analogicus/cnr_gr05_sky130nm/README.md

# CNR_GR05_SKY130NM

# Who
wulff

# Why
 <explain why you made this module>

# How
 <explain short how you made this module>

# What

| What | Lib/Folder | Cell/Name |
| :- | :-: | :-: |
| Schematic | CNR_GR05_SKY130NM | CNR_GR05 |
| Layout | CNR_GR05_SKY130NM | CNR_GR05 |
| LPE | CNR_GR05_SKY130NM | CNR_GR05 |

# Changelog/Plan
| Version | Status | Comment|
| :-| :-| :-|
|0.1.0 | :x: | Make something |

# Signal interface
| Signal | Direction | Domain  | Description |
| :--- | :---: | :---: | :--- |
| VDD_1V8 | Input | VDD_1V8 | Main supply |
| VSS | Input | Ground  | |
| PWRUP_1V8 | Input | VDD_1V8 | Power up the circuit |

# Key parameters
| Parameter | Min | Typ | Max | Unit  |
| :--- | :-: | :-: | :-: | :---: |
| Technology | | Skywater 130 nm | | |
| AVDD | 1.7 | 1.8 | 1.9 | V |
| Temperature | -40 | 27 | 125 | C |

# Status

| Stage | TYPE | Status | Comment |
| :--- | :-:  | :---:  | :--: |
| Specification | DOC  | :x: | |
| Schematic | VIEW | :x: | |
| Schematic simulation | VER  | N/A | |
| Layout | VIEW | :x: | |
| Layout parasitic extraction | VIEW | :x: | |
| LPE simulation | VER  | :x: | |
| LVS | VER  | :x: | |
| DRC | VER  | :x: | |
| ERC | VER  | :x: | |
| ANT | VER  | :x: | |
