analogicus/cnr_gr05_sky130nm/documents/Assignment-M1-Advanced-Integrated-Circuits-Group-5.pdf

Department of Electronic Systems

TFE 4188 - Advanced Integrated Circuits

# Assignment M1 - Group 5

Authors:
Markus Pedersen
Andrea Al Muktash
Michal Rowicki
Trond Christiansen

Date: 08.02.2024

## Table of Contents

List of Figures | ii
1 Introduction | 1
2 Key Parameters | 1
3 Specification | 1
4 Verification Plan | 1
5 Functional Description | 2
6 Architecture | 2
7 SPICE Simulations | 4

i

## List of Figures

1 | OTA design | | 2
2 | Top level design | | 3
3 | Simulation of current and temperature from -40 °C to 125 °C in cicsim | | 4
4 | Simulation of current and temperature from -40 °C to 125 °C in NGSPICE . . . . | 4
5 | Plots of measured current and ideal current from -40 °C to 125 °C | | 5
6 | Simulated current consumption from -40 °C to 125 °C | | 5

ii

## 1 Introduction

For this milestone, the goal is to create a circuit design that implements the functionality of con-verting a temperature to a current. The design utilizes the Skywater Open Source PDK and its SKY130 process node.

This report serves as preliminary documentation of the current progress of the project.

## 2 Key Parameters

The following table presents the key parameters for the design.

Table 1: Key parameters

Name | Description | Min | Typ | Max | Unit
Width | Maximum width | - | - | 160 | µm
Height | Maximum height | - | - | 100 | µm
VDD | Input supply | 1.62 | 1.80 | 1.98 | V
Temperature | Temperature range to measure | -40 | - | 125 | °C
Current | Input current | - | 120 | 200 | µA

## 3 Specification

The following table presents the specifications for the design.

Table 2: Specifications

Name | Description | Min | Typ | Max | Unit | Notes
Accuracy | One-point accuracy | -5 | 0 | +5 | °C | -
Resolution | Temperature resolution | - | - | - | °C | TBD
Stability | - | - | - | - | - | TBD
Power consumption Noise | -Noise of the OTA | -- | -- | -- | W V /√ | TBD
| | | | | Hz | TBD
Offset | Offset of the OTA | - | - | - | V | TBD
CMRR | CMRR of the OTA | - | - | - | dB | TBD
Gain | Gain of the OTA | - | - | - | - | TBD

## 4 Verification Plan

### 4.1 Accuracy

The accuracy of the current-to-temperature design will be verified by simulating the design in the entire temperature range. Afterward, the data will be extracted and compared to the ideal current function.

### 4.2 Current Consumption

The current consumption of the design will be simulated by measuring the current from the supply for the entire temperature range using a DC analysis testbench.

## 5 Functional Description

The project group is designing an IC temperature sensor using the SkyWater130 CMOS technology.

The intention is to use a circuit that generates a PTAT current. It is based on a modified Kuijk band gap reference mechanism i.e. using the VBE voltage of a BJT (used as a diode):

VBE =

kT
q
- ln(

ID
IS

)

## 6 Architecture

### 6.1 OTA Subcircuit

The following figure presents the OTA subcircuit:

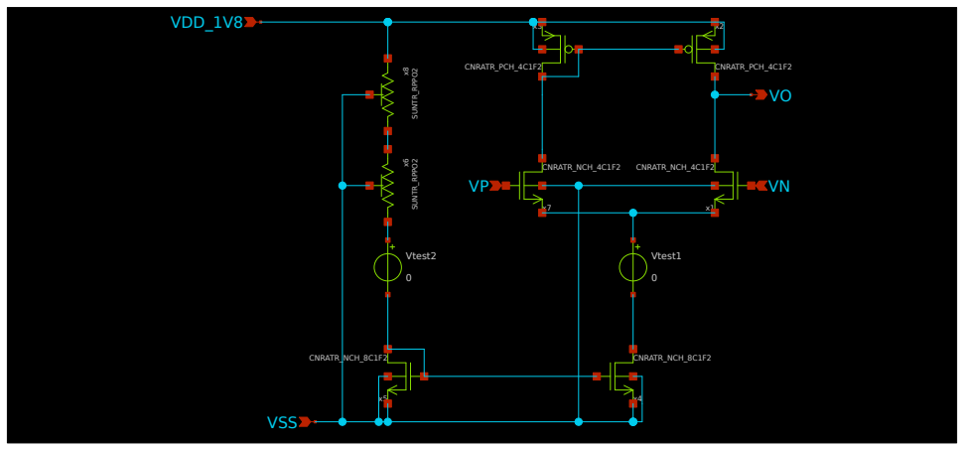
[picture p2: figure]
VDD_1V8; VSS; Vtest1; CNRATR_NCH_4C1F2; CNRATR_PCH_4C1F2; CNRATR_NCH_8C1F2; Vtest2; SUNTR_RPPO2

Figure 1: OTA design

The amplifier in negative feedback forces a 0 differential voltage. Hence, scaling the diode sizes properly, one can get a resulting voltage drop over the resistance of VB1 − VB2, thus generating the PTAT current:

IP T AT =

kT
q
- ln(n) ·

1
R

To bias the simple five-transistor OTA, a 60 µA current is desired. For that current, the 8C1F2 has a given gate-source voltage of VGS = 0.75V for gm
id

= 15. Since the supply voltage is VDD = 1.8, the required resistor value can be calculated using:

R =

VDD − VGS
I

=

1.8V − 0.75V
60µA = 17.5kΩ

The implemented design uses two 8.8 k Ω in series.
The tail transistor is twice the size of the input transistors so it can carry twice the current.

### 6.2 Top Design

The following figure presents the top-level design: VP

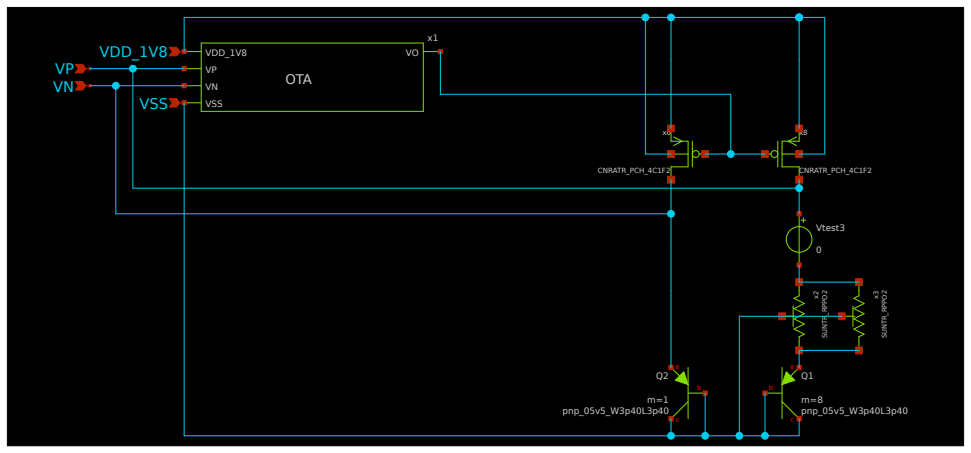
[picture p3: figure]
VSS; VDD_1V8; pnp_05v5_W3p40L3p40; CNRATR_PCH_4C1F2; Vtest3; SUNTR_RPPO2; OTA

Figure 2: Top level design

The pnp BJTs work similar to diodes when operating in the triode region. The diode current
I = IS · e

qVBE
kT

where the reverse saturation current is proportional to the emitter area

IS ∝ AE

implies that

VBE =

kT
q

ln(

I
IS

)

From this, one can calculate the voltage drop over the resistors:

VR = VEB1 − VEB2 =

kT
q
- ln(

I1
IS1

) −

kT
q
- ln(

I2
IS2

) = kT
q
- ln(n)

where n is the ratio of the pnp emitter areas.
Using an equivalent resistance of 4.4kΩ and a pnp emitter area ratio of n = 8, one can calculate the predicted ideal slope of the temperature to current function:

Iout =

kT
q
- ln(n)

4.4kΩ

∝ T

Iout
T

=

k
q
- ln(8) ·

1
4.4kΩ

≈ 40.8nA/K

## 7 SPICE Simulations

All simulations presented in this section were performed in the typical corner.

### 7.1 Simulation of Current against Temperature

The following figures present the simulation results of the proposed design. The simulations were performed by configuring a temperature sweep from -40 °C to 125 °C using the following SPICE commands:

op t r an 1 1 1 10n 20u 0
DC temp −40 125 1

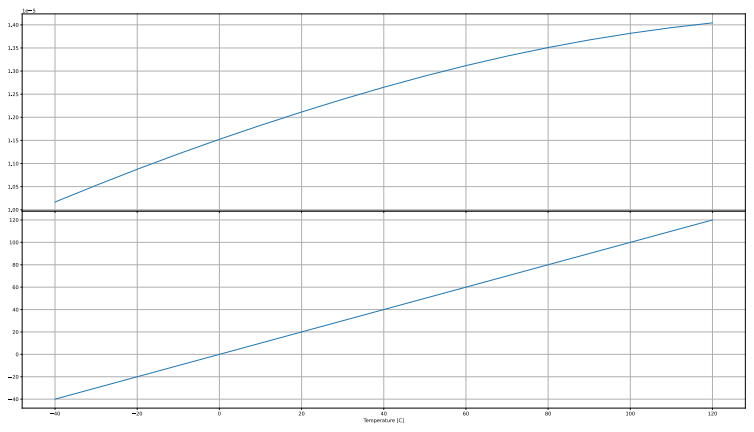
[picture p4: figure]

Figure 3: Simulation of current and temperature from -40 °C to 125 °C in cicsim

temp-sweep

dc1: cicsimgen tran

-40.0 | -20.0 | 0.0 | 20.0 | 40.0 | 60.0 | 80.0 | 100.0 | 120.0
| | | | | Celsius

10.0

10.5

11.0

11.5

12.0

12.5

13.0

13.5

14.0

14.5

uA | i(v.xdut.vtest3)

Figure 4: Simulation of current and temperature from -40 °C to 125 °C in NGSPICE

### 7.2 Calculation of Current Error

By extracting the data and running it in a simple Python script, one can compute the error of the measured current compared to the ideal current, as shown in the following figure:

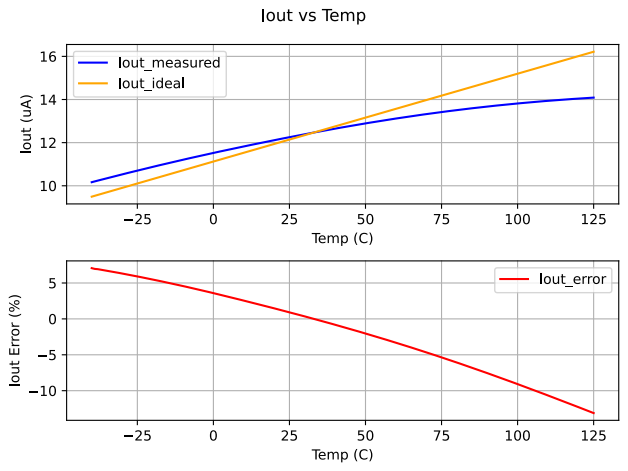
[picture p5: figure]

Figure 5: Plots of measured current and ideal current from -40 °C to 125 °C

One can observe that the measured current curve is non-linear and deviates from the ideal current by up to 14 %. The group hypothesizes that this is caused by the temperature dependence of the resistors and intends to address this in the next revision.

### 7.3 Simulation of Current Consumption

The following figure shows the simulated current consumption of the circuit:

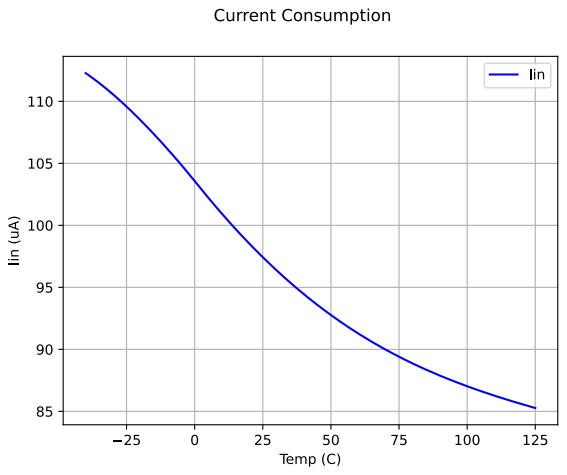
[picture p6: figure]

Figure 6: Simulated current consumption from -40 °C to 125 °C

The current consumption decreases due to the mirror ratio in the OTA worsening, which is some-thing requiring further investigation. A possible hypothesis is the tail current going into the ohmic region.
