analogicus/cnr_gr05_sky130nm/design/CNR_GR05_SKY130NM/Openlane/PulseDurationMeasurement/runs/RUN_2024.04.19_11.37.55/reports/metrics.csv

design | design_name | config | flow_status | total_runtime | routed_runtime | (Cell/mm^2)/Core_Util | DIEAREA_mm^2 | CellPer_mm^2 | OpenDP_Util | Final_Util | Peak_Memory_Usage_MB | synth_cell_count | tritonRoute_violations | Short_violations | MetSpc_violations | OffGrid_violations | MinHole_violations | Other_violations | Magic_violations | pin_antenna_violations | net_antenna_violations | lvs_total_errors | cvc_total_errors | klayout_violations | wire_length | vias | wns | pl_wns | optimized_wns | fastroute_wns | spef_wns | tns | pl_tns | optimized_tns | fastroute_tns | spef_tns | HPWL | routing_layer1_pct | routing_layer2_pct | routing_layer3_pct | routing_layer4_pct | routing_layer5_pct | routing_layer6_pct | wires_count | wire_bits | public_wires_count | public_wire_bits | memories_count | memory_bits | processes_count | cells_pre_abc | AND | DFF | NAND | NOR | OR | XOR | XNOR | MUX
/openlane/designs/PulseDurationMeasurement | PulseDurationMeasurement | RUN_2024.04.19_11.37.55 | flow failed | 1h6m10s0ms | 0h51m5s0ms | 102368.54600276935 | 0.3779871993 | 51184.273001384674 | 51.19 | 45.384299999999996 | 1244.77 | 18964 | 0 | 0 | 0 | 0 | 0 | 0 | 0 | 27 | 19 | 0 | -1 | -1 | 628886 | 137793 | -3.41 | -1 | -1 | -1 | -1 | -38.65 | -1 | -1 | -1 | -1 | 510097031.0 | 0.0 | 46.68 | 50.16 | 11.22 | 22.14 | 0.0 | 19963 | 20516 | 51 | 465 | 0 | 0 | 0 | 20485 | 75 | 155 | 500 | 1064 | 2829 | 3527 | 2042 | 1375
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
