analogicus/cnr_gr05_sky130nm/design/CNR_GR05_SKY130NM/Openlane/PulseDurationMeasurement/runs/RUN_2024.04.19_13.24.54/reports/metrics.csv

design | design_name | config | flow_status | total_runtime | routed_runtime | (Cell/mm^2)/Core_Util | DIEAREA_mm^2 | CellPer_mm^2 | OpenDP_Util | Final_Util | Peak_Memory_Usage_MB | synth_cell_count | tritonRoute_violations | Short_violations | MetSpc_violations | OffGrid_violations | MinHole_violations | Other_violations | Magic_violations | pin_antenna_violations | net_antenna_violations | lvs_total_errors | cvc_total_errors | klayout_violations | wire_length | vias | wns | pl_wns | optimized_wns | fastroute_wns | spef_wns | tns | pl_tns | optimized_tns | fastroute_tns | spef_tns | HPWL | routing_layer1_pct | routing_layer2_pct | routing_layer3_pct | routing_layer4_pct | routing_layer5_pct | routing_layer6_pct | wires_count | wire_bits | public_wires_count | public_wire_bits | memories_count | memory_bits | processes_count | cells_pre_abc | AND | DFF | NAND | NOR | OR | XOR | XNOR | MUX
/openlane/designs/PulseDurationMeasurement | PulseDurationMeasurement | RUN_2024.04.19_13.24.54 | flow completed | 0h4m17s0ms | 0h3m6s0ms | 92474.72410474686 | 0.033414536025000004 | 46237.36205237343 | 52.05 | 64.55199999999999 | 567.47 | 1199 | 0 | 0 | 0 | 0 | 0 | 0 | 0 | 0 | 0 | 0 | -1 | -1 | 36073 | 9421 | 0.0 | -1 | -1 | -1 | -1 | 0.0 | -1 | -1 | -1 | -1 | 22116453.0 | 0.0 | 36.54 | 36.76 | 3.07 | 5.0 | 0.0 | 495 | 796 | 45 | 325 | 0 | 0 | 0 | 782 | 23 | 32 | 18 | 4 | 52 | 5 | 6 | 282
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
