analogicus/cnr_gr05_sky130nm/design/CNR_GR05_SKY130NM/Openlane/PulseDurationMeasurement/src/verilog_include_file.v

// Macros
`define STA         0       // Status register          0x00    RO
`define TMPH        1       // Temperature high byte    0x01    RO  
`define TMPL        2       // Temperature low byte     0x02    RO
`define RAWH        3       // Raw data high byte       0x03    RO
`define RAWL        4       // Raw data low byte        0x04    RO
`define CTL         5       // Control register         0x05    RW
`define RES1        6       // Reserved                 0x06    RW
`define RES2        7       // Reserved                 0x07    RW
`define OFS_3       8       // Offset register 3        0x08    RW
`define OFS_2       9       // Offset register 2        0x09    RW
`define OFS_1       10      // Offset register 1        0x0A    RW
`define OFS_0       11      // Offset register 0        0x0B    RW
`define OFS_SHA     12      // Offset Shift amount reg  0x0C    RW
`define GAIN1_3     13      // Gain1 register 3         0x0D    RW
`define GAIN1_2     14      // Gain1 register 2         0x0E    RW
`define GAIN1_1     15      // Gain1 register 1         0x0F    RW
`define GAIN1_0     16      // Gain1 register 0         0x10    RW
`define GAIN1_SHA   17      // Gain1 shift amount reg   0x11    RW
`define GAIN2_3     18      // Gain2 register 3         0x12    RW
`define GAIN2_2     19      // Gain2 register 2         0x13    RW
`define GAIN2_1     20      // Gain2 register 1         0x14    RW
`define GAIN2_0     21      // Gain2 register 0         0x15    RW
`define GAIN2_SHA   22      // Gain2 shift amount reg   0x16    RW
`define GAIN3_3     23      // Gain3 register 3         0x17    RW
`define GAIN3_2     24      // Gain3 register 2         0x18    RW
`define GAIN3_1     25      // Gain3 register 1         0x19    RW
`define GAIN3_0     26      // Gain3 register 0         0x1A    RW
`define GAIN3_SHA   27      // Gain3 shift amount reg   0x1B    RW



module PulseDurationMeasurement(
    input wire clk,             // Clock input
    input wire reset_n,         // Reset input
    input wire RS,              // Register Select input
    input wire RW,              // Read/Write input
    input wire EN,              // Enable input
    input wire [7:0] data_in,   // Data bus input
    input wire signal_in,       // Signal input
    output reg [7:0] data_out   // Data bus output
);

// Internal variables
reg [5:0] address = 1'b000000;            // Address bus 6-bit
reg [7:0] data_reg [30:0];           // Data register 8-bit

reg state = 0;
reg [11:0] count, pulse_duration;

reg signed [31:0] c_offset, c_gain1, c_gain2, c_gain3;
reg signed [15:0] temperature_output = 0; // Signed temperature value output
reg [64:0] tmp;

reg [32:0] u_offset, u_gain1, u_gain2, u_gain3;
reg [7:0] u_offset_sha, u_gain1_sha, u_gain2_sha, u_gain3_sha;

// Constants declaration
parameter IDLE = 1'b0;
parameter COUNT = 1'b1;

// Constants for temperature conversion
parameter GAIN3 = -508; // (-0.0000004731 * 1073741824) scaled by 2^30
parameter GAIN2 = 2101; // (0.0020044419 * 1048576) scaled by 2^20
parameter GAIN = -2532; // (-2.4734734627 * 1024) scaled by 2^10
parameter OFFSET = 847;

parameter CALEN_bm = (1 << 7);  // Calibration enable bit mask
parameter CALSEL_bm = ((1 << 6) | (1 << 5));  // Calibration 3 bit mask
parameter CAL_3 = ((1 << 6) | (1 << 5));  // Calibration 3
parameter CAL_2 = ((1 << 6) | (0 << 5));  // Calibration 2
parameter CAL_1 = ((0 << 6) | (1 << 5));  // Calibration 1
parameter CAL_0 = ((0 << 6) | (0 << 5));  // Calibration 0


always_ff @(posedge clk) begin
    if(!reset_n) begin
        data_out = 8'b00000000;
        address = 6'b000000;
    end
    else if(EN == 1) begin
        if(RS == 1 && RW == 0) begin        // Read data
            data_out = data_reg[address];
            if(data_reg[address] != 0) begin
                //$display($stime,"\t\t\t\t\t Reading data %d from address %d", data_out, address);
            end
        end
        else if(RS == 1 && RW == 1) begin   // Write data
        // TODO: Write protection for read-only registers
            if(address >= 5 && address <= 30) begin
                data_reg[address] = data_in;
                //$display($stime,"\t\t\t\t\tWriting data %d to address %d", data_in, address);
            end
        end
        else if(RS == 0 && RW == 0) begin   // Read address
            data_out = address;
            if(address != 0) begin
                //$display($stime,"\t\t\t\t\tReading address %d", address);
            end
        end
        else if(RS == 0 && RW == 1) begin   // Write address
            address = data_in[5:0];
            //$display($stime,"\t\t\t\t\tAddress set to %d from %d", address, data_in);
        end
        else begin                          // Default
            data_out = 8'b00000000;
        end
    end
end

always_ff @(posedge clk) begin
    if(!reset_n) begin
        state <= IDLE;
        count <= 12'h0;
    end else begin
        case(state)
            IDLE: begin
                count <= 12'b000000000001;
                if (signal_in == 0) begin
                    state <= COUNT;
                    // Calculated temperature message printed here at to allow for temperature conversion to be done
                    //$display($stime,"\t\t\t\t\tMeasurement finished \t\t Old temperature: %d \t New temperature:", temperature_output);
                end 
            end

            COUNT: begin
                if (signal_in == 0) begin
                    count <= count + 1;
                end else begin
                    pulse_duration <= count;

                    data_reg[`RAWH] <= 8'b0 | pulse_duration[11:8];
                    data_reg[`RAWL] <= pulse_duration[7:0];
                    // Finished counting message printed here at to only display once per measurement
                    //$display($stime,"\t\t\t\t\tCount finished \t\t Pulse Duration: %d", pulse_duration);
                    state <= IDLE;
                end
            end
        endcase
    end
end

//always_comb begin
always_ff @(posedge clk) begin
    // // Concatenate the offset registers to form a 32-bit signed integer
    // c_offset = data_reg[`OFS_3] << 24 | data_reg[`OFS_2] << 16 | data_reg[`OFS_1] << 8 | data_reg[`OFS_0];
    // c_gain1 = data_reg[`GAIN1_3] << 24 | data_reg[`GAIN1_2] << 16 | data_reg[`GAIN1_1] << 8 | data_reg[`GAIN1_0];
    // c_gain2 = data_reg[`GAIN2_3] << 24 | data_reg[`GAIN2_2] << 16 | data_reg[`GAIN2_1] << 8 | data_reg[`GAIN2_0];
    // c_gain3 = data_reg[`GAIN3_3] << 24 | data_reg[`GAIN3_2] << 16 | data_reg[`GAIN3_1] << 8 | data_reg[`GAIN3_0];


    c_offset =  data_reg[`OFS_1] << 8 | data_reg[`OFS_0];
    c_gain1 =  data_reg[`GAIN1_1] << 8 | data_reg[`GAIN1_0];
    c_gain2 =  data_reg[`GAIN2_1] << 8 | data_reg[`GAIN2_0];
    c_gain3 =  data_reg[`GAIN3_1] << 8 | data_reg[`GAIN3_0];


    if(!reset_n) begin
        temperature_output = 16'b0;
    end
    else if (data_reg[`CTL] & CALEN_bm) begin // Calibration enabled
        if ((data_reg[`CTL] & CALSEL_bm) == CAL_0) begin

            // // Standard calibration with custom offset
            // tmp = ((GAIN3*pulse_duration*pulse_duration*pulse_duration) >> 30) 
            //         + ((GAIN2*pulse_duration*pulse_duration) >> 20) 
            //         + ((GAIN*pulse_duration) >> 10)
            //         + c_offset;
            // temperature_output = tmp[15:0];

            //u_gain1 = GAIN3;
            u_gain2 = GAIN2;
            u_gain3 = GAIN;
            u_offset = c_offset;

            u_gain1_sha = 30;
            u_gain2_sha = 20;
            //u_gain3_sha = 10;
            u_offset_sha = data_reg[`OFS_SHA];

            // $display($s  time,"\tstandard calibration with custom offset");
            // $display($stime,"\t %d * %d^3 / 2^%d + %d * %d^2 / 2^%d + %d * %d / 2^%d + %d", GAIN3, pulse_duration, 30, GAIN2, pulse_duration, 20, GAIN, pulse_duration, 10, c_offset);
            // $display($stime,"\t\t\tTemperature: %d", temperature_output);
        end
        else if ((data_reg[`CTL] & CALSEL_bm) == CAL_1) begin

            // tmp = ((c_gain1*pulse_duration) >> data_reg[`GAIN1_SHA]) 
            //         + (c_offset >> data_reg[`OFS_SHA]);
            // temperature_output = tmp[15:0];

            u_gain1 = c_gain1;
            u_gain2 = 0;
            //u_gain3 = 0;
            u_offset = c_offset;

            u_gain1_sha = data_reg[`GAIN1_SHA];
            u_gain2_sha = 0;
            //u_gain3_sha = 0;
            u_offset_sha = data_reg[`OFS_SHA];

            // $display($stime,"\tcustom calibration 1");
            // $display($stime,"\t %d * %d / 2^%d + %d", c_gain1, pulse_duration, data_reg[`GAIN1_SHA], c_offset);
            // $display($stime,"\t\t\tTemperature: %d", temperature_output);
        end
        else if ((data_reg[`CTL] & CALSEL_bm) == CAL_2) begin

            // tmp = ((c_gain2*pulse_duration*pulse_duration) >> data_reg[`GAIN2_SHA])
            //         + ((c_gain1*pulse_duration) >> data_reg[`GAIN1_SHA]) 
            //         + (c_offset >> data_reg[`OFS_SHA]);
            // temperature_output = tmp[15:0];

            u_gain1 = c_gain1;
            u_gain2 = c_gain2;
            //u_gain3 = 0;
            u_offset = c_offset;

            u_gain1_sha = data_reg[`GAIN1_SHA];
            u_gain2_sha = data_reg[`GAIN2_SHA];
            //u_gain3_sha = 0;
            u_offset_sha = data_reg[`OFS_SHA];

            // $display($stime,"\tcustom calibration 2");
            // $display($stime,"\t %d * %d^2 / 2^%d + %d * %d / 2^%d + %d", c_gain2, pulse_duration, data_reg[`GAIN2_SHA], c_gain1, pulse_duration, data_reg[`GAIN1_SHA], c_offset);
            // $display($stime,"\t\t\tTemperature: %d", temperature_output);
        end
        else if ((data_reg[`CTL] & CALSEL_bm) == CAL_3) begin

            // tmp = ((c_gain3*pulse_duration*pulse_duration*pulse_duration) >> data_reg[`GAIN3_SHA])
            //         + ((c_gain2*pulse_duration*pulse_duration) >> data_reg[`GAIN2_SHA])
            //         + ((c_gain1*pulse_duration) >> data_reg[`GAIN1_SHA]) 
            //         + (c_offset >> data_reg[`OFS_SHA]);
            // temperature_output = tmp[15:0];

            u_gain1 = c_gain1;
            u_gain2 = c_gain2;
            //u_gain3 = c_gain3;
            u_offset = c_offset;

            u_gain1_sha = data_reg[`GAIN1_SHA];
            u_gain2_sha = data_reg[`GAIN2_SHA];
            //u_gain3_sha = data_reg[`GAIN3_SHA];
            u_offset_sha = data_reg[`OFS_SHA];

            // $display($stime,"tustom calibration 3");
            // $display($stime,"\t %d * %d^3 / 2^%d + %d * %d^2 / 2^%d + %d * %d / 2^%d + %d", c_gain3, pulse_duration, data_reg[`GAIN3_SHA], c_gain2, pulse_duration, data_reg[`GAIN2_SHA], c_gain1, pulse_duration, data_reg[`GAIN1_SHA], c_offset);
            // $display($stime,"\t\t\tTemperature: %d", temperature_output);
        end

    end
    else begin  // Custom calibration disabled

        // tmp = ((GAIN3*pulse_duration*pulse_duration*pulse_duration) >> 30) 
        //             + ((GAIN2*pulse_duration*pulse_duration) >> 20) 
        //             + ((GAIN*pulse_duration) >> 10) 
        //             + OFFSET;
        // temperature_output = tmp[15:0];

        u_gain1 = GAIN3;
        u_gain2 = GAIN2;
        //u_gain3 = GAIN;
        u_offset = OFFSET;

        u_gain1_sha = 30;
        u_gain2_sha = 20;
        //u_gain3_sha = 10;
        u_offset_sha = 0;

        // $display($stime,"\tstandard calibration");
        // $display($stime,"\t %d * %d^3 / 2^%d + %d * %d^2 / 2^%d + %d * %d / 2^%d + %d", GAIN3, pulse_duration, 30, GAIN2, pulse_duration, 20, GAIN, pulse_duration, 10, OFFSET);
        // $display($stime,"\t\t\tTemperature: %d", temperature_output);
    end

    // tmp = ((u_gain3*pulse_duration*pulse_duration*pulse_duration) >> u_gain3_sha) 
    //         + ((u_gain2*pulse_duration*pulse_duration) >> u_gain2_sha) 
    //         + ((u_gain1*pulse_duration) >> u_gain1_sha) 
    //         + u_offset;
    // temperature_output = tmp[15:0];
    tmp = ((u_gain2*pulse_duration*pulse_duration) >> u_gain2_sha) 
            + ((u_gain1*pulse_duration) >> u_gain1_sha) 
            + u_offset;

    //$display($stime,"\t\t\t\t\tTemperature: %d", temperature_output);
    data_reg[`TMPH] = temperature_output[15:8];
    data_reg[`TMPL] = temperature_output[7:0];
    
end

endmodule
