analogicus/cnr_gr05_sky130nm/design/CNR_GR05_SKY130NM/Openlane/PulseDurationMeasurement/runs/RUN_2024.04.19_13.24.54/results/placement/PulseDurationMeasurement.nl.v

module PulseDurationMeasurement (EN,
    RS,
    RW,
    clk,
    reset_n,
    signal_in,
    data_in,
    data_out);
 input EN;
 input RS;
 input RW;
 input clk;
 input reset_n;
 input signal_in;
 input [7:0] data_in;
 output [7:0] data_out;

 wire _0000_;
 wire _0001_;
 wire _0002_;
 wire _0003_;
 wire _0004_;
 wire _0005_;
 wire _0006_;
 wire _0007_;
 wire _0008_;
 wire _0009_;
 wire _0010_;
 wire _0011_;
 wire _0012_;
 wire _0013_;
 wire _0014_;
 wire _0015_;
 wire _0016_;
 wire _0017_;
 wire _0018_;
 wire _0019_;
 wire _0020_;
 wire _0021_;
 wire _0022_;
 wire _0023_;
 wire _0024_;
 wire _0025_;
 wire _0026_;
 wire _0027_;
 wire _0028_;
 wire _0029_;
 wire _0030_;
 wire _0031_;
 wire _0032_;
 wire _0033_;
 wire _0034_;
 wire _0035_;
 wire _0036_;
 wire _0037_;
 wire _0038_;
 wire _0039_;
 wire _0040_;
 wire _0041_;
 wire _0042_;
 wire _0043_;
 wire _0044_;
 wire _0045_;
 wire _0046_;
 wire _0047_;
 wire _0048_;
 wire _0049_;
 wire _0050_;
 wire _0051_;
 wire _0052_;
 wire _0053_;
 wire _0054_;
 wire _0055_;
 wire _0056_;
 wire _0057_;
 wire _0058_;
 wire _0059_;
 wire _0060_;
 wire _0061_;
 wire _0062_;
 wire _0063_;
 wire _0064_;
 wire _0065_;
 wire _0066_;
 wire _0067_;
 wire _0068_;
 wire _0069_;
 wire _0070_;
 wire _0071_;
 wire _0072_;
 wire _0073_;
 wire _0074_;
 wire _0075_;
 wire _0076_;
 wire _0077_;
 wire _0078_;
 wire _0079_;
 wire _0080_;
 wire _0081_;
 wire _0082_;
 wire _0083_;
 wire _0084_;
 wire _0085_;
 wire _0086_;
 wire _0087_;
 wire _0088_;
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
    .Q(\data_reg[24][6] ));
 sky130_fd_sc_hd__dfxtp_1 _1947_ (.CLK(clk),
    .D(_0187_),
    .Q(\data_reg[24][7] ));
 sky130_fd_sc_hd__dfxtp_1 _1948_ (.CLK(clk),
    .D(_0188_),
    .Q(\data_reg[25][0] ));
 sky130_fd_sc_hd__dfxtp_1 _1949_ (.CLK(clk),
    .D(_0189_),
    .Q(\data_reg[25][1] ));
 sky130_fd_sc_hd__dfxtp_1 _1950_ (.CLK(clk),
    .D(_0190_),
    .Q(\data_reg[25][2] ));
 sky130_fd_sc_hd__dfxtp_1 _1951_ (.CLK(clk),
    .D(_0191_),
    .Q(\data_reg[25][3] ));
 sky130_fd_sc_hd__dfxtp_1 _1952_ (.CLK(clk),
    .D(_0192_),
    .Q(\data_reg[25][4] ));
 sky130_fd_sc_hd__dfxtp_1 _1953_ (.CLK(clk),
    .D(_0193_),
    .Q(\data_reg[25][5] ));
 sky130_fd_sc_hd__dfxtp_1 _1954_ (.CLK(clk),
    .D(_0194_),
    .Q(\data_reg[25][6] ));
 sky130_fd_sc_hd__dfxtp_1 _1955_ (.CLK(clk),
    .D(_0195_),
    .Q(\data_reg[25][7] ));
 sky130_fd_sc_hd__dfxtp_1 _1956_ (.CLK(clk),
    .D(_0196_),
    .Q(\data_reg[26][0] ));
 sky130_fd_sc_hd__dfxtp_1 _1957_ (.CLK(clk),
    .D(_0197_),
    .Q(\data_reg[26][1] ));
 sky130_fd_sc_hd__dfxtp_1 _1958_ (.CLK(clk),
    .D(_0198_),
    .Q(\data_reg[26][2] ));
 sky130_fd_sc_hd__dfxtp_1 _1959_ (.CLK(clk),
    .D(_0199_),
    .Q(\data_reg[26][3] ));
 sky130_fd_sc_hd__dfxtp_1 _1960_ (.CLK(clk),
    .D(_0200_),
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
