analogicus/cnr_gr05_sky130nm/design/CNR_GR05_SKY130NM/Openlane/PulseDurationMeasurement/runs/RUN_2024.04.19_13.24.54/results/placement/PulseDurationMeasurement.pnl.v

module PulseDurationMeasurement (EN,
    RS,
    RW,
    clk,
    reset_n,
    signal_in,
    VPWR,
    VGND,
    data_in,
    data_out);
 input EN;
 input RS;
 input RW;
 input clk;
 input reset_n;
 input signal_in;
 input VPWR;
 input VGND;
 input [7:0] data_in;
 output [7:0] data_out;

 wire _0000_;
 wire _0001_;
 wire _0002_;
 wire _0003_;
 wire _0004_;
 wire _0005_;
 wire _0006_;
 wire _0007_;
 wire _0008_;
 wire _0009_;
 wire _0010_;
 wire _0011_;
 wire _0012_;
 wire _0013_;
 wire _0014_;
 wire _0015_;
 wire _0016_;
 wire _0017_;
 wire _0018_;
 wire _0019_;
 wire _0020_;
 wire _0021_;
 wire _0022_;
 wire _0023_;
 wire _0024_;
 wire _0025_;
 wire _0026_;
 wire _0027_;
 wire _0028_;
 wire _0029_;
 wire _0030_;
 wire _0031_;
 wire _0032_;
 wire _0033_;
 wire _0034_;
 wire _0035_;
 wire _0036_;
 wire _0037_;
 wire _0038_;
 wire _0039_;
 wire _0040_;
 wire _0041_;
 wire _0042_;
 wire _0043_;
 wire _0044_;
 wire _0045_;
 wire _0046_;
 wire _0047_;
 wire _0048_;
 wire _0049_;
 wire _0050_;
 wire _0051_;
 wire _0052_;
 wire _0053_;
 wire _0054_;
 wire _0055_;
 wire _0056_;
 wire _0057_;
 wire _0058_;
 wire _0059_;
 wire _0060_;
 wire _0061_;
 wire _0062_;
 wire _0063_;
 wire _0064_;
 wire _0065_;
 wire _0066_;
 wire _0067_;
 wire _0068_;
 wire _0069_;
 wire _0070_;
 wire _0071_;
 wire _0072_;
 wire _0073_;
 wire _0074_;
 wire _0075_;
 wire _0076_;
 wire _0077_;
 wire _0078_;
 wire _0079_;
 wire _0080_;
 wire _0081_;
 wire _0082_;
 wire _0083_;
 wire _0084_;
 wire _0085_;
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
    .VNB(VGND),
    .VPB(VPWR),
    .VPWR(VPWR),
    .Y(_0472_));
 sky130_fd_sc_hd__or2_1 _1548_ (.A(\count[4] ),
    .B(_0470_),
    .VGND(VGND),
    .VNB(VGND),
    .VPB(VPWR),
    .VPWR(VPWR),
    .X(_0473_));
 sky130_fd_sc_hd__a32o_1 _1549_ (.A1(_0467_),
    .A2(_0472_),
    .A3(_0473_),
    .B1(_0437_),
    .B2(\count[4] ),
    .VGND(VGND),
    .VNB(VGND),
    .VPB(VPWR),
    .VPWR(VPWR),
    .X(_0280_));
 sky130_fd_sc_hd__and3_1 _1550_ (.A(\count[5] ),
    .B(\count[4] ),
    .C(_0470_),
    .VGND(VGND),
    .VNB(VGND),
    .VPB(VPWR),
    .VPWR(VPWR),
    .X(_0474_));
 sky130_fd_sc_hd__inv_2 _1551_ (.A(_0474_),
    .VGND(VGND),
    .VNB(VGND),
    .VPB(VPWR),
    .VPWR(VPWR),
    .Y(_0475_));
 sky130_fd_sc_hd__a21o_1 _1552_ (.A1(\count[4] ),
    .A2(_0470_),
    .B1(\count[5] ),
    .VGND(VGND),
    .VNB(VGND),
    .VPB(VPWR),
    .VPWR(VPWR),
    .X(_0476_));
 sky130_fd_sc_hd__a32o_1 _1553_ (.A1(_0467_),
    .A2(_0475_),
    .A3(_0476_),
    .B1(_0437_),
    .B2(\count[5] ),
    .VGND(VGND),
    .VNB(VGND),
    .VPB(VPWR),
    .VPWR(VPWR),
    .X(_0281_));
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
