analogicus/cnr_gr05_sky130nm/(commit log)

2023-09-28 Made CNR_GR05_SKY130NM
    [CNR_GR05.sch]
2024-02-02 First OTA simulation
    [CNR_GR05.sch]
2024-02-02 Added '''''' good '''''' OTA
    [GOOD_OTA.sch]
2024-02-05 ''' working ''' OTA
    [CNR_GR05.sch, GOOD_OTA.sch, temp2cur.sch]
2024-02-06 full circuit
    [CNR_GR05.sch, temp2cur.sch]
2024-02-09 working circuit
    [CNR_GR05.sch, temp2cur.sch]
2024-02-09 added back anotation files
    [BACK_ANOTATE.sch]
2024-02-09 OTA with currente ''''' reference '''''
    [CNR_GR05.sch, OTA.sch]
2024-02-19 constant gm iref for ota
    [IREF.sch, OTA.sch]
2024-02-23 functioning integrator
    [CNR_GR05.sch]
2024-02-26 working milestone 2
    [CNR_GR05.sch, STRNGARM.sch]
2024-02-28 ISRC improvment attempts
    [CNR_GR05.sch, IREF.sch, OTA_alt1.sch, OTA_alt2.sch]
2024-02-29 Added timestep
    [CNR_GR05.sch]
2024-03-01 Auto reset atempt
    [AND.sch, CNR_GR05_b.sch, inv.sch]
2024-03-01 Working reset circuit
    [OR.sch, POSEDGE.sch]
2024-03-01 Slowed down to usable speeds
    [CNR_GR05.sch, POSEDGE.sch]
2024-03-03 reset and pulse extender
    [CNR_GR05.sch, POSEDGE.sch]
2024-03-04 Cleaned up circuit
    [CNR_GR05.sch]
2024-03-10 working cosim
    [CNR_GR05.sch]
2024-03-18 Verilog part working with second order compensation
    [CNR_GR05.sch]
2024-04-11 layout stuff
    [CNR_GR05.sch, CNR_GR05_v2.sch, OTA.sch, PTAT.sch, current_ref_v2.sch, test.sch]
2024-04-16 random mess
    [CNR_GR05.sch, INV.sch, IREF.sch, POSEDGE.sch]
2024-04-17 layout so far
    [IREF.sch, OTA.sch, POSEDGE.sch]
2024-04-19 layout pushed before everything bugs out
    [POSEDGE.sch, PTAT.sch, capacitor.sch, final.sch]
2024-04-19 here you go
    [INTEGRATOR.sch, final.sch]
2024-04-19 finished analog layout
    [final.sch]
2024-04-19 correct layout
    [PTAT.sch]
2024-04-26 sim of "final"
    [final.sch]
2024-04-26 fixed layout posedge
    [POSEDGE.sch]
2024-05-03 Auto stash before merge of "Old_design" and "origin/Old_design"
    [INTEGRATOR.sch, PTAT.sch, final.sch]
2024-05-03 Added Openlane
    [24-wire_lengths.csv, PTAT.sch, PulseDurationMeasurement.Fastest.sdf, PulseDurationMeasurement.Slowest.sdf, PulseDurationMeasurement.Typical.sdf, PulseDurationMeasurement.sdf, metrics.csv, pin_order.cfg]
